jochenalt/Paul/README.md

# Paul
Paul is a depressed robot balancing on his ball. Check my [hackaday page](https://hackaday.io/project/20045-paul).
    
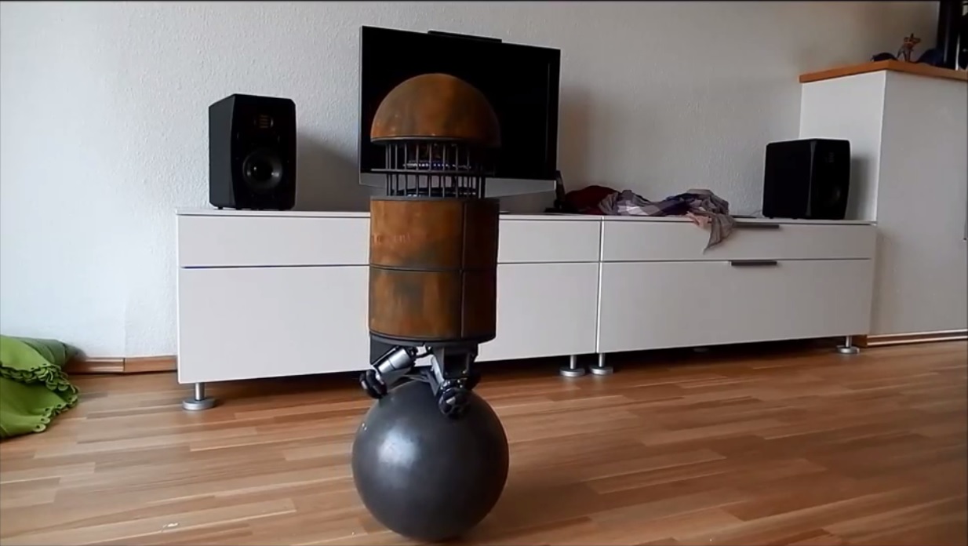
[picture p1: Paul.jpg]
