jochenalt/Paul/source/Display/Paul/Images.pptx

Paul Options Speech

Options
Remote Paul Config

Speech
Poems Songs Talk

Night hate
How I hate the night
Hairy
How hairy are my legs

4 [ ]

mm
s

Pos = (192,312)
Tilt = (0.1°,0.2°)
w = 2 °/s
Remote has 11,3V
Paul has 11,7V

10 [ ]

mm
s

Paul Options Speech

I did not ask to switch me on.

Paul

> Don‘t switch me on

Speech
Talk Poems Songs

> Hello.
> I did not ask to switch me on.

4 [ ]

mm
s

10 [ ]

mm
s

Options
Paul Remote Config

Sandy
Select the voice
English
Select the language

>I did not ask to switch
me on.

Options
Config Remote Paul

Main Menu
H - help

Paul

## Slide 2

## Slide 3

Paul Options Speech

Paul Options Speech

4 [ ]

mm
s

4 [ ]

mm
s

10 [ ]

mm
s

Pos = (192,312)
Tilt = (0.1°,0.2°)
w = 2 °/s
Remote has 11,3V
Paul has 11,7V

10 [ ]

mm
s

I did not ask to switch me on

## Slide 4

Options
Remote Config Paul

Options
Paul Config Remote

Options
Config Paul

Main Menu
H - help

Sandy
Select the voice
English
Select the language

## Slide 5

Speech
Poems Songs Talk

Night hate
How I hate the night
Hairy
How hairy are my legs

Speech
Songs Poems Talk

Favourite Things
Jazz classic
Edelweiss
Traditional

Speech
Talk Poems Songs

Hello
My name is Paul
I did not ask to switch me on
