jochenalt/Paul/Mechanics/Ballbot Kinematics.xlsx

Sheet: Kinematix
Kinematix |  |  |  |  |  |  | Inverse Kinematics
q | 40 ° | Angle between horzontal and one wheel
 | 120.0 mm | radius of ball
 | 24.0 mm | radius of wheel
dT | 0.01 s | time since last measurement
current absolute Map position
 | 1000 mm | absolute x-position on map
 | 1000 mm | absolute y-position on map
 | 50 mm | absolute movement along x
 | 0 mm | absolute movement along y
 | 10.0 °/s | angular velocity around z
Position in IMU coord-system |  |  |  |  |  |  | 351
d | 0.100 ° | angle within last dT |  |  |  |  | -914.3981981
 | 48.000 mm | corrected relative x movement |  |  |  |  | -0.3838590241
 | 0.087 mm | corrected relative x movement
vector in IMU coord-system |  |  |  |  |  | Kinematics |  |  |  |  |  |  | Inverse Kinematics
 | 10 mm/s | speed in x coord |  |  |  |  | -18.3 °/s | -3.047993994 rpm | angular velocity of wheel 1 |  |  |  |  | 10.0 mm/s
 | 0 mm/s | speed in y coord |  |  |  |  | 9.1 °/s | 1.523996997 rpm | angular velocity of wheel 2 |  |  |  |  | 0.0 mm/s
 | 0.0 °/s | angular velocity around z |  |  |  |  | 9.1 °/s | 1.523996997 rpm | angular velocity of wheel 3 |  |  |  |  | 0.0 °/s
new Map position
 | 1050 mm | absolute new x position
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
