jochenalt/Paul/docs/formulas.docx

[ω_(w1) ω_(w2) ω_(w3) ]=-1/(r_w) (0, cosθ, -sinθ-(√3)/2 cosθ, -(cosθ)/2, -sinθ(√3)/2 cosθ, -(cosθ)/2, -sinθ)R^T (0, -1, 01, 0, 00, 0, -r_b )[v_x v_y ω_(bz) ]

R_x *R_y =[1, 0, 00, cosφ_x , -sinφ_x 0, sinφ_x , cosφ_x ] [cosφ_y , 0, sinφ_y 0, 1, 0- sinφ_y , 0, cosφ_y ]=[cosφ_y , 0, sinφ_y sinφ_x sinφ_y , cosφ_x , -sinφ_x cosφ_y -cosφ_x sinφ_y , sinφ_x , cosφ_x cosφ_y ]

(0, -1, 01, 0, 00, 0, -r_b )^(-1) *R^() (0, cosθ, -sinθ-(√3)/2 cosθ, -(cosθ)/2, -sinθ(√3)/2 cosθ, -(cosθ)/2, -sinθ)^(-1) [ω_(w1) ω_(w2) ω_(w3) ](-r_w )=[v_x v_y ω_(bz) ]
