jochenalt/Paul/datasheets/ELV I2C LED Driver 16 Channels/BackView.jpg

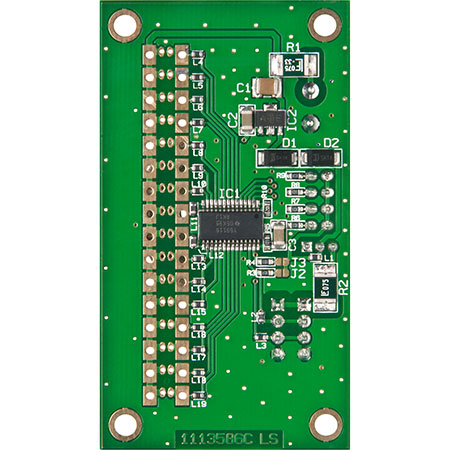
datasheets/ELV I2C LED Driver 16 Channels/BackView.jpg
