jochenalt/Paul/datasheets/ELV I2C LED Driver 16 Channels/Frontview.jpg

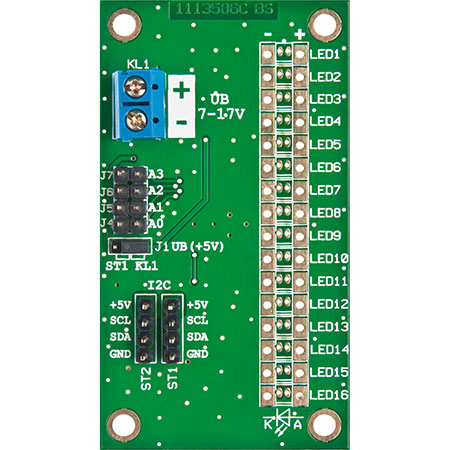
datasheets/ELV I2C LED Driver 16 Channels/Frontview.jpg
