jochenalt/Paul/datasheets/ELV Mini USB Uart/PIN Belegung.PNG

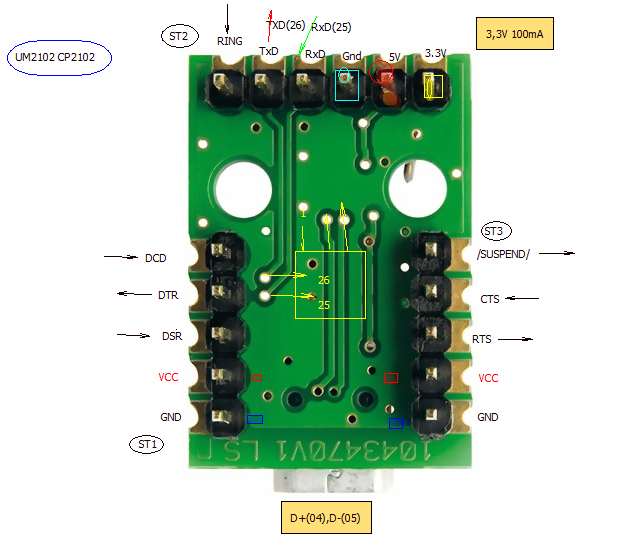
datasheets/ELV Mini USB Uart/PIN Belegung.PNG
