jochenalt/Paul/datasheets/EMIC-2 Text2Speech/BackView.jpg

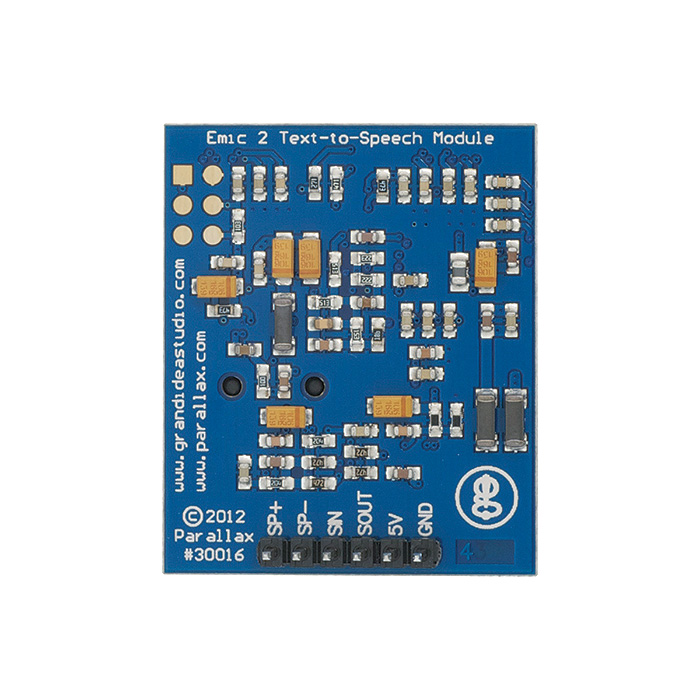
datasheets/EMIC-2 Text2Speech/BackView.jpg
