jochenalt/Paul/datasheets/EMIC-2 Text2Speech/FrontView.jpg

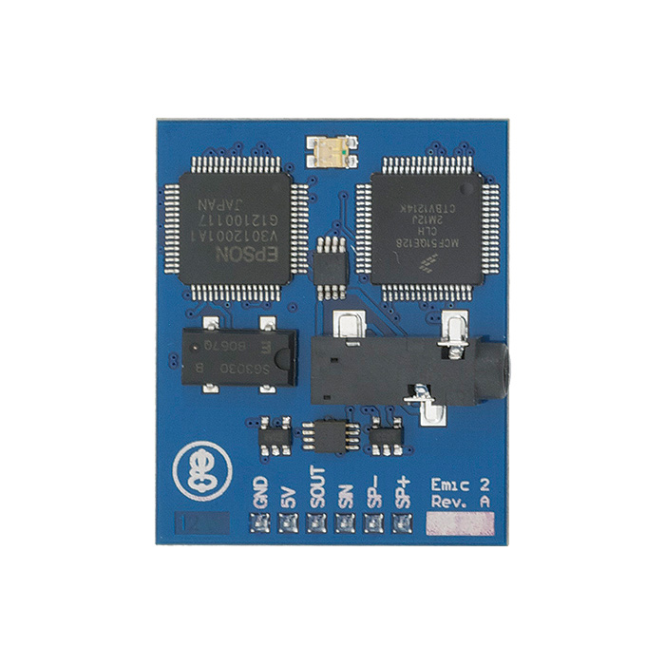
datasheets/EMIC-2 Text2Speech/FrontView.jpg
