jochenalt/Paul/datasheets/Single Motor Driver Carrier Board VNH2SP30.jpg

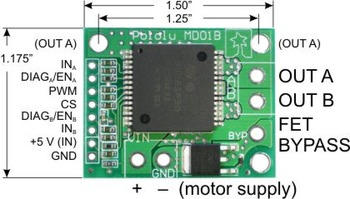
datasheets/Single Motor Driver Carrier Board VNH2SP30.jpg
