jochenalt/Paul/docs/images/overview.png

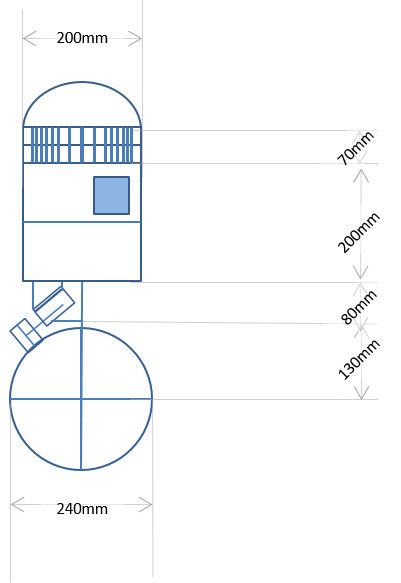
docs/images/overview.png
