jochenalt/Paul/Schematics/Bot Board/Bot Board Plot.png

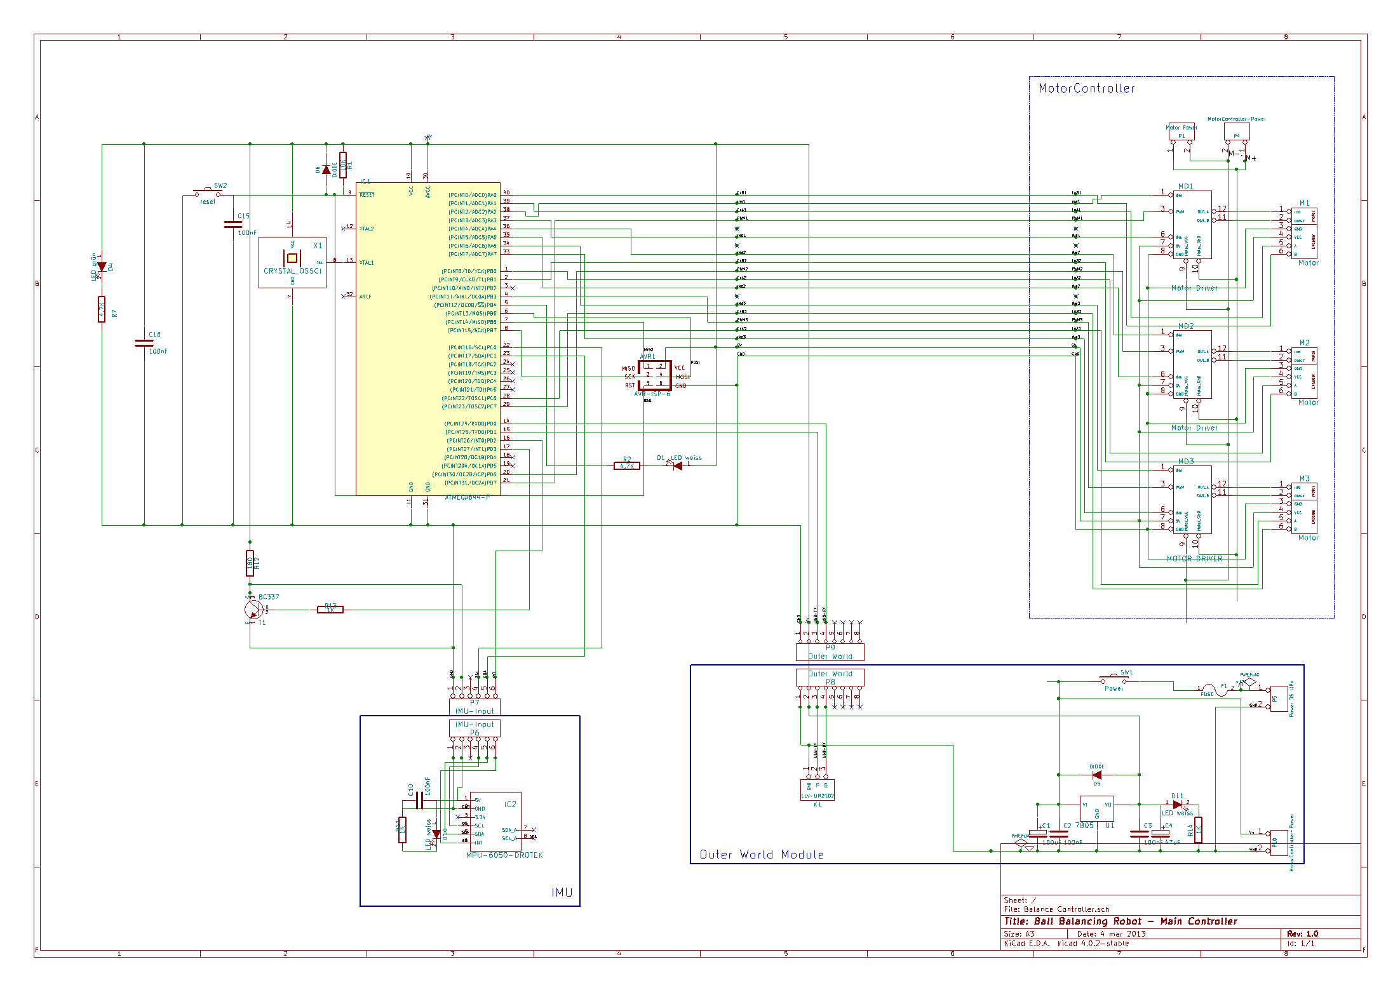
Schematics/Bot Board/Bot Board Plot.png
