jochenalt/Paul/Mechanics/Construction.pptx

schematics - sketch

Balance Controller

Main Controller

Led Controller

I2C LED Driver

I2C LED Driver

Motordriver 1
Motor Controller

PWM/encoder AB

Atmega 644
Balance Controller

I2C

Motordriver 2
Motor Controller

UART

Atmega 644
Main Controller

XBee
Remote Receiver

16Channel LED driver

Motordriver 3
Motor Controller

UART

Emic-2
Dectalk Controller

MPU6050

16 Channel LED driver

Loudspeaker

## Slide 2

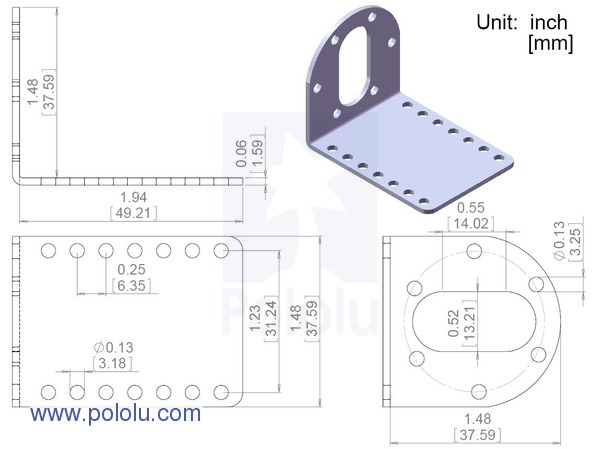
[picture p13: figure]
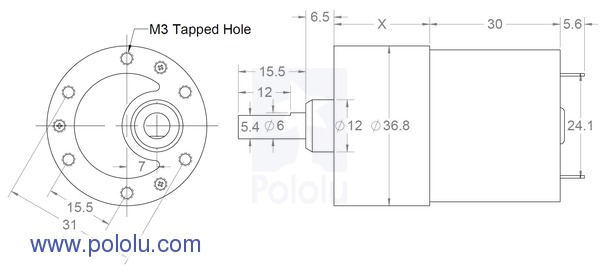
[picture p14: figure]

7mm

7mm

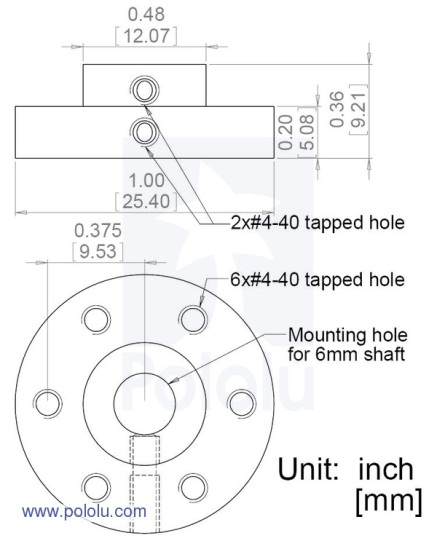
[picture p15: figure]

25mm

20,5mm

27,5mm

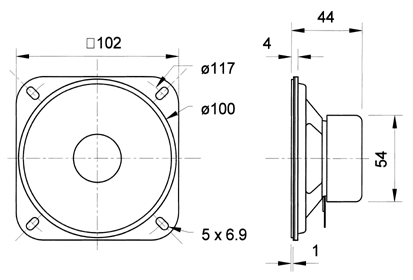
[picture p16: figure]

http://www.visaton.de/de/chassis_zubehoer/breitband/f8sc_8.html

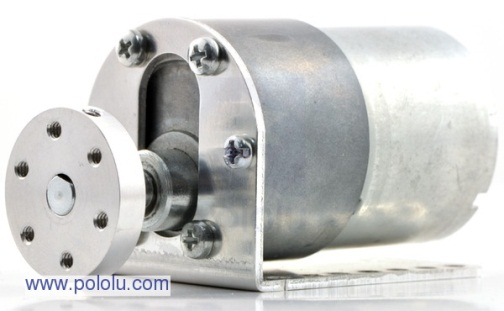
[picture p17: figure]

14,5mm

Visaton R 10 SC - 8 Ohm

7mm

## Slide 3

140mm

A=95,7

6+3mm

26mm

1mm

4mm

30mm

b=57mm

sin(40°)*120mm

21mm

40°

B =48,4+ 9 + cos(40°)*(120+24+30mm)+sin(40°)*(21mm)

147mm

b=195,1mm

24+30mm

48mm

40°

R=120 mm

sin(40°)*(120mm+24mm)

A = sin(40°)*(120mm+24mm+30) - cos(40)*(21mm)=
sin(40)* (174)-cos(40)*21

## Slide 4

r=80mm / 80mm

3 mm

38,6 mm

45,6 mm

71,6 mm

17 mm

3 mm

3 mm

10 mm

27mm

3 mm

6 mm

3 mm

40 mm

6mm

9mm

37mm

52mm

r=11,5/90 mm

## Slide 5

200mm

70mm

200mm

80mm

130mm

240mm

## Slide 6

Motor platform with 40° angle II

Draw that line

## Slide 7

Motor platform with 40° angle II

## Slide 8

Motor platform stabilization cross

3

1

2

1

1

1

## Slide 9

Motor platform stabilization cross

4

6

5

## Slide 10

Motor platform II –bottom side
6mm birch

## Slide 11

Motor platform II -upper side
3mm birch

mill
1mm depth

## Slide 12

middle body platform
3mm

## Slide 13

Dalek body
side panel
3mm

## Slide 14

top body platform – bottom side
6mm
Visaton F-8 SC

mill
1mm depth

Visaton
R 10 SC
8 Ohm

## Slide 15

head platform
1x 3mm
1x 6mm

## Slide 16

Hat bracket
1x 6mm

## Slide 17

housing
3mm

## Slide 18

Dress I
3mm
2x

## Slide 19

3x Kegel
Innen 20cm*pi= 62,8cm
Aussen 28cm*pi= 87,9cm
Kante 6,9cm
R1+Sqrt(5,7cm²+4²cm)=r2
R1*2PI*f=62,8
R2 *2PI*f= 87,9
f = 62,8/(2*PI*r1) = 87,9/(2*pi*r2)
R1 = 2,8c/87,9*r2
R2 = r1/62,8*29,32 = r1+6,9
R1*(87,9/62,8 -1) = 6,9
R1 =6,2/(87,9/62,8-1) = 15,51cm
R2 = 22,41
F= 0,644= 231°
231/3 = 77,33

## Slide 20

Dress I-1
3mm

Circles
1x
rout =10,18cm
rinner=8,0cm
2x Circle
rout =14cm
rinner=12,0cm
1x circle
rout =14cm
rinner=13,0cm

6x Part 1

12x Part 2

P2

P2

Part 1

P2

6x Part 3

6x Part 4

6x Part 5

## Slide 21

Dress I-2
3mm

## Slide 22

IMU bracket

10*PI

## Slide 23

3

1

2

## Slide 24

5

LED Head

6mm

6mm

6

4

## Slide 25

Klappe

PAUL

MOTOR

UPRIGHT

uC MAIN

ERROR

NO IDEA

uC BOT

## Slide 26

Panel

## Slide 27

Remote

## Slide 28

## Slide 29

## Slide 30
