jochenalt/Paul/Schematics/Bot Board/Balance Controller.sch

## KiCad design Schematics/Bot Board/Balance Controller.sch (2017-02-27)

Schematic: Balance Controller.sch

Parts:
AVR1: AVR-ISP-6
C1: 100uF
C2, C3, C10, C15, C16: 100nF
C4: 47uF
D1, D10, D11: LED weiss
D4: LED grün
D5, D6: DIODE
F1: FUSE
IC1: ATMEGA644-P; DIL40
IC2: MPU-6050-DROTEK
K1: ELV-UM2102
M1, M2, M3: Motor
MD1, MD2: Motor Driver
MD3: MOTOR DRIVER
P1: Motor Power
P4, P10: MotorController-Power
P5: Power 3S LiPo
P6, P7: IMU-Input
P8, P9: Outer World
R1: 10K
R2, R7: 4,7K
R11, R13, R14: 1K
R12: 180
SW1: Power
SW2: reset
T1: BC337
U1: 7805
X1: CRYSTAL_OSSCI

Connections:
+5V: AVR1.2, C1.1, C2.1, C3.1, C4.1, C16.1, D1.1 (A), D4.1 (A), D5.1 (A), D5.2 (K), D6.2 (K), D11.1 (A), IC1.10 (VCC), IC1.30 (AVCC), M1.4 (VCC), M2.4 (VCC), M3.4 (VCC), MD1.7 (5V), MD2.7 (5V), MD3.7 (5V), P8.2, P9.2, P10.1, R1.1, R12.1, SW1.1, U1.VI, U1.VO, X1.14 (VCC)
+12V: F1.2, P5.1
EnA1: IC1.39 ((PCINT1/ADC1)PA1), M1.5 (A)
EnA2: IC1.1 ((PCINT8/T0/XCK)PB0), M2.5 (A)
EnA3: IC1.28 ((PCINT22/TOSC1)PC6), M3.5 (A)
EnB1: IC1.40 ((PCINT0/ADC0)PA0), M1.6 (B)
EnB2: IC1.2 ((PCINT9/CLKO/T1)PB1), M2.6 (B)
EnB3: IC1.29 ((PCINT23/TOSC2)PC7), M3.6 (B)
GND: AVR1.6, C1.2, C2.2, C3.2, C4.2, C15.2, C16.2, IC1.11 (GND), IC1.31 (GND), K1.1 (GND), M1.3 (GND), M2.3 (GND), M3.3 (GND), MD1.8 (GND), MD2.8 (GND), MD3.8 (GND), P5.2 (PM), P7.1, P8.1, P9.1, P10.2 (PM), R7.2, R14.1, SW2.1, T1.1 (E), U1.GND, X1.7 (GND)
INT: IC1.16 ((PCINT26/INT0)PD2), P7.6
INa2: IC1.36 ((PCINT4/ADC4)PA4), MD2.1 (INa)
INa3: IC1.34 ((PCINT6/ADC6)PA6), MD3.1 (INa)
INb1: IC1.37 ((PCINT3/ADC3)PA3), MD1.6 (INb)
INb2: IC1.35 ((PCINT5/ADC5)PA5), MD2.6 (INb)
INb3: IC1.33 ((PCINT7/ADC7)PA7), MD3.6 (INb)
Ina1: IC1.38 ((PCINT2/ADC2)PA2), MD1.1 (INa)
M+: MD1.10 (Motor_GND), MD2.10 (Motor_GND), MD3.10 (Motor_GND), P1.1, P4.1
MISO: AVR1.1, IC1.7 ((PCINT14/MISO)PB6)
MOSI: AVR1.4, IC1.6 ((PCINT13/MOSI)PB5)
unnamed: AVR1.3, IC1.8 ((PCINT15/SCK)PB7)
unnamed: C10.1, P6.1, R11.1
unnamed: C10.2, D10.1 (A), P6.2
unnamed: D1.2 (K), R2.2
unnamed: D4.2 (K), R7.1
unnamed: D10.2 (K), R11.2
unnamed: D11.2 (K), R14.2
unnamed: F1.1, SW1.2
unnamed: IC1.5 ((PCINT12/OC0B/~SS~)PB4), R2.1
unnamed: IC1.13 (XTAL1), X1.8 (TAL)
unnamed: IC1.17 ((PCINT27/INT1)PD3), R13.2
unnamed: M1.1 (red), MD1.12 (OUT_A)
unnamed: M1.2 (black), MD1.11 (OUT_B)
unnamed: M2.1 (red), MD2.12 (OUT_A)
unnamed: M2.2 (black), MD2.11 (OUT_B)
unnamed: M3.1 (red), MD3.12 (OUT_A)
unnamed: M3.2 (black), MD3.11 (OUT_B)
unnamed: MD1.9 (Motor_VCC), MD2.9 (Motor_VCC), MD3.9 (Motor_VCC), P1.2 (PM), P4.2 (PM)
unnamed: P7.2, R12.2, T1.3 (C)
unnamed: R13.1, T1.2 (B)
PWM1: IC1.21 ((PCINT31/OC2A)PD7), MD1.3 (PWM)
PWM2: IC1.20 ((PCINT30/OC2B/ICP)PD6), MD2.3 (PWM)
PWM3: IC1.4 ((PCINT11/AIN1/OC0A)PB3), MD3.3 (PWM)
RST: AVR1.5, C15.1, D6.1 (A), IC1.9 (~RESET), R1.2, SW2.2
SCL: IC1.22 ((PCINT16/SCL)PC0), P7.4
SDA: IC1.23 ((PCINT17/SDA)PC1), P7.5
USB-RX: IC1.14 ((PCINT24/RXD0)PD0), K1.3 (RX), P8.4, P9.4
USB-TX: IC1.15 ((PCINT25/TXD0)PD1), K1.2 (TX), P8.3, P9.3

Notes on the sheet:
Outer World Module
IMU
MotorController
