jochenalt/Paul/Schematics/Main Board/Main Controller.sch

## KiCad design Schematics/Main Board/Main Controller.sch (2017-02-27)

Schematic: Main Controller.sch

Parts:
AVR1: AVR-ISP-6
C1: 100uF
C2, C3, C6, C15: 100nF
C4: 220uF
D1: LED weiss
D5, D6: DIODE
F1: FUSE
IC1: ATMEGA644-P; DIL40
IC3: XBee Explorer Regulated
IC6: EMIC-2
K1: LED BUS
P1: Motor Power
P4: Panel
P5: Power in 3S LiPo
P7: Loudspeaker
P9: Balance Board
P15: Speaking Pin
P22: LED Phalanx
R1, R9, R10, R11, R21, R22: 10K
R2, R14, R17, R18, R19, R20: 1K
R8: 56K
R23: 2.2K
SW2: reset
U1: 7805
X1: CRYSTAL_OSSCI

Connections:
+5V: AVR1.2, C3.1, C4.1, D5.1 (A), D6.2 (K), IC1.10 (VCC), IC1.30 (AVCC), IC6.2 (+5V), P9.2, R1.1, R14.1, R21.1, R22.1, U1.VO, X1.14 (VCC)
+12V: F1.1, P4.2
B-SW -: AVR1.6, C1.2, C2.2, C3.2, C4.2, C6.2, C15.2, D1.2 (K), IC1.11 (GND), IC1.31 (GND), IC6.1 (GND), K1.4, K1.5, P1.2 (PM), P4.5, P5.2 (PM), P9.1, P22.1, R9.2, R10.1, SW2.1, U1.GND, X1.7 (GND)
B-SW+: IC1.28 ((PCINT22/TOSC1)PC6), P4.4
BLED: P22.5, R20.1
Bot V+: C1.1, C2.1, D5.2 (K), K1.1, P4.3, R8.2, U1.VI
DLED: P22.6, R17.1
ELED: P22.3, R19.1
IsTalking: P15.1, R18.2
LiPo V+: F1.2, P5.1
M V+: P1.1, P4.1, R23.2
MISO: AVR1.1, IC1.7 ((PCINT14/MISO)PB6)
MLED: P22.4, R23.1
MOSI: AVR1.4, IC1.6 ((PCINT13/MOSI)PB5)
unnamed: C6.1, IC6.6 (SP+), P7.1, R11.2
unnamed: D1.1 (A), R2.2
unnamed: IC1.1 ((PCINT8/T0/XCK)PB0), IC6.3 (Rx)
unnamed: IC1.2 ((PCINT9/CLKO/T1)PB1), IC6.4 (Tx)
unnamed: IC1.3 ((PCINT10/AIN0/INT2)PB2), R18.1
unnamed: IC1.13 (XTAL1), X1.8 (TAL)
unnamed: IC1.20 ((PCINT30/OC2B/ICP)PD6), R17.2
unnamed: IC1.21 ((PCINT31/OC2A)PD7), R19.2
unnamed: IC1.29 ((PCINT23/TOSC2)PC7), R20.2
unnamed: IC1.38 ((PCINT2/ADC2)PA2), R10.2, R11.1
unnamed: IC1.39 ((PCINT1/ADC1)PA1), R2.1
unnamed: IC1.40 ((PCINT0/ADC0)PA0), R8.1, R9.1
unnamed: IC6.5 (SP-), P7.2 (PM)
PLED: P22.2, R14.2
RST: AVR1.5, C15.1, D6.1 (A), IC1.9 (~RESET), R1.2, SW2.2
RXD1: IC1.16 ((PCINT26/INT0)PD2), P9.3
SCK: AVR1.3, IC1.8 ((PCINT15/SCK)PB7)
SCL: IC1.22 ((PCINT16/SCL)PC0), K1.3, R22.2
SDA: IC1.23 ((PCINT17/SDA)PC1), K1.2, R21.2
TXD1: IC1.17 ((PCINT27/INT1)PD3), P9.4
XBee-Rx: IC1.14 ((PCINT24/RXD0)PD0)
XBee-Tx: IC1.15 ((PCINT25/TXD0)PD1)
