jochenalt/Paul/Schematics/Remote Control/Remote Control.sch

## KiCad design Schematics/Remote Control/Remote Control.sch (2017-02-27)

Schematic: Remote Control.sch

Parts:
AVR1: AVR-ISP-6
C1: 100uF
C2, C3, C5, C15: 100nF
C4: 220 uF
D4: 1N4004
D5, D6: DIODE
D7: LED
D8: Power-LED
F1: FUSE
IC1: ATMEGA644-P; DIL40
IC3: XBee Explorer Regulated
IC4: ELV-UM2102
K1: RELAY_2RT_SMALL
K3: CONN-UM-2102
P1: Joystick Conn
P2: LCD-DIP-SPI
P3, P6: Power-Supply
P4: LCD Connector
P5: Power in 3S LiPo
P7, P8: LCD
P10: LCD_DIP_MIDDLE
P11: LCD-DIP_FLASH
Q1: PNP
R1, R4, R9, R15: 10K
R2, R10: 2.2K
R3, R5, R6, R7, R8, R11, R14, R16: 1K
R12: 56K
R13: 100
SW1: Power-Button
SW2: uC reset
U1: 7805
X1: CRYSTAL_OSSCI

Connections:
+5V: AVR1.2, D6.2 (K), IC1.10 (VCC), IC1.30 (AVCC), P1.2, P6.3, P8.2, R1.1, X1.14 (VCC)
+12V: F1.1, K1.6 (C2), SW1.1
Baud0: P11.5
Baud1: P11.6
Baud2: P11.7
CLK: P8.7, P10.8
Disp-CLK: P4.9, P7.7
Disp-Flash-RX: P4.10, P7.9
Disp-GND: P4.1, P7.1
Disp-MISO/Baud2: P4.8, P7.6
Disp-MOSI/Baud1: P4.7, P7.5
Disp-RESET: P4.5, P7.10
Disp-SPIMO/TX: P4.11, P7.8
Disp-SS/Baud0: P4.6, P7.4
Disp-VDD: P4.2, P7.2
GND: AVR1.6, C1.2, C2.2, C3.2, C4.2, C5.2, C15.2, D7.2 (K), D8.2 (K), IC1.11 (GND), IC1.31 (GND), K1.8, K3.1, P1.1, P2.3, P3.1, P5.2 (PM), P6.1, P8.1, R3.2, R4.2, R5.2, R9.2, R11.2, SW2.1, U1.GND, X1.7 (GND)
LCD-Flash-RX: P8.9, P10.4
LCD-Reset: P8.10
LCD-Rx: P11.2, P11.4
LCD-SBUF: P4.20, P7.3
LCD-Tx: P11.1, P11.3
LiPo V+: F1.2, P5.1
MISO: AVR1.1, IC1.7 ((PCINT14/MISO)PB6), P2.7
MISO/Baud2: P8.6, P10.7
MOSI: P2.6, R10.2
MOSI/Baud1: P8.5, P10.6
unnamed: AVR1.4, IC1.6 ((PCINT13/MOSI)PB5), R10.1
unnamed: C1.1, C2.1, D5.2 (K), K1.5 (T2), R12.2, R14.1, U1.VI
unnamed: C3.1, C4.1, D5.1 (A), P3.3, Q1.1 (E), U1.VO
unnamed: C5.1, IC1.32 (AREF)
unnamed: D4.1 (A), R4.1, R15.2, SW1.2 (PM)
unnamed: D4.2 (K), R13.1
unnamed: D7.1 (A), R16.2
unnamed: D8.1 (A), R14.2
unnamed: IC1.1 ((PCINT8/T0/XCK)PB0), P6.4
unnamed: IC1.2 ((PCINT9/CLKO/T1)PB1), P6.5
unnamed: IC1.13 (XTAL1), X1.8 (TAL)
unnamed: IC1.14 ((PCINT24/RXD0)PD0), P2.2
unnamed: IC1.15 ((PCINT25/TXD0)PD1), P2.1
unnamed: IC1.33 ((PCINT7/ADC7)PA7), R16.1
unnamed: IC1.36 ((PCINT4/ADC4)PA4), R3.1, R8.1
unnamed: IC1.37 ((PCINT3/ADC3)PA3), R5.1, R7.1
unnamed: IC1.38 ((PCINT2/ADC2)PA2), R6.1, R11.1
unnamed: IC1.40 ((PCINT0/ADC0)PA0), P6.2
unnamed: K1.1, K1.3 (C1), R13.2
unnamed: K1.4 (T1), Q1.3 (C)
unnamed: P3.2, R9.1, R12.1
unnamed: P3.4, R2.1
unnamed: P3.5, R15.1
unnamed: Q1.2 (B), R2.2
RST: AVR1.5, C15.1, D6.1 (A), IC1.9 (~RESET), R1.2, SW2.2
RX: K3.3, P10.2
RXD1: IC1.16 ((PCINT26/INT0)PD2)
SBUF: IC1.20 ((PCINT30/OC2B/ICP)PD6), P8.3
SCK: AVR1.3, IC1.8 ((PCINT15/SCK)PB7), P2.8
SPI/Flash-TX: P8.8, P10.3
SS: IC1.21 ((PCINT31/OC2A)PD7), P2.5
SS/Baud0: P8.4, P10.5
TX: K3.2 (PM), P10.1
TXD1: IC1.17 ((PCINT27/INT1)PD3)
X: P1.3, R8.2
Y: P1.4, R7.2
jb: IC1.29 ((PCINT23/TOSC2)PC7), P1.6
z: P1.5, R6.2
